avirtuos/ros_hercules/(commit log)

2016-06-11 Initial commit - Initializing git-hub repo w/Readme - Adding core components for ros SLAM using: HectorSlam, rplidar, rosserial (for arduino integration) - Adding basic arduino sketch for interfacing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
2016-06-11 Adding simple web server to hercules_core.py which reports the latest sensor data from the arduino motor controller as well as the largest distance seen by the lidar. This is mostly a testing iterati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
2016-06-14 Added some more experiemation hooks for exploring crude obstacle detection algorithms that are very much if-this-then-that and seeing first hand why these strategies do not work and develop loops. Al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
    [hercules_core.py, hercules_rosserial.ino]
2016-07-16 Prototype with naive, no code structure. Mostly a scratch pad, expect to begin refining after a few more experiements. I'm commiting mostly to have a history of the progression
2016-07-16 Basic obstacle avoidance and mapping works
    [hercules_core.py, hercules_rosserial.ino]
2016-07-16 Better obstacle avoidance, using more encoder feedback in decision making
    [hercules_core.py]
2016-07-17 Config adjustment for map tif interval and small bug fix for way-point transitions in niave wandering rover experiemnt.
    [hercules_core.py]
2016-07-23 Adding support for Zed Camera from StereoLabs as well as pointcloud to laser scan. Some of these dependencies are branches of existing projects so please consult their respective lisences.
    [Zed.cfg]
2016-07-25 Switch from pointcloud_to_laserscan to depthimage_to_laserscan as it improved laser scan HZ by 10x mostly because zed_wrapper has to do considerable work to create a pointcloud from the high res dept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
2016-07-31 Adding support for voltage sensory to arduino sketch, still need to update sample python handler.
2016-07-31 Adding comment about voltage sensor calibration factor.
2016-07-31 Updating README and documentation for the harder layout as well as some tips on the ZED camera.
2016-09-11 Updating arduino code to use Mega2560 Mini ( http://wiki.epalsite.com/index.php?title=Mega2560_Pro_Mini ) instead of Arduino Pro Micro 5v. This changes offers us sufficient GPIO to add an IMU (9-degr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
2016-12-17 Fixing hercules_rosserial.ino to work with Arduino Mega2560 Mini
    [hercules_rosserial.ino]
